johndavid400/Isotope11_traffic_lights/traffic_light.png

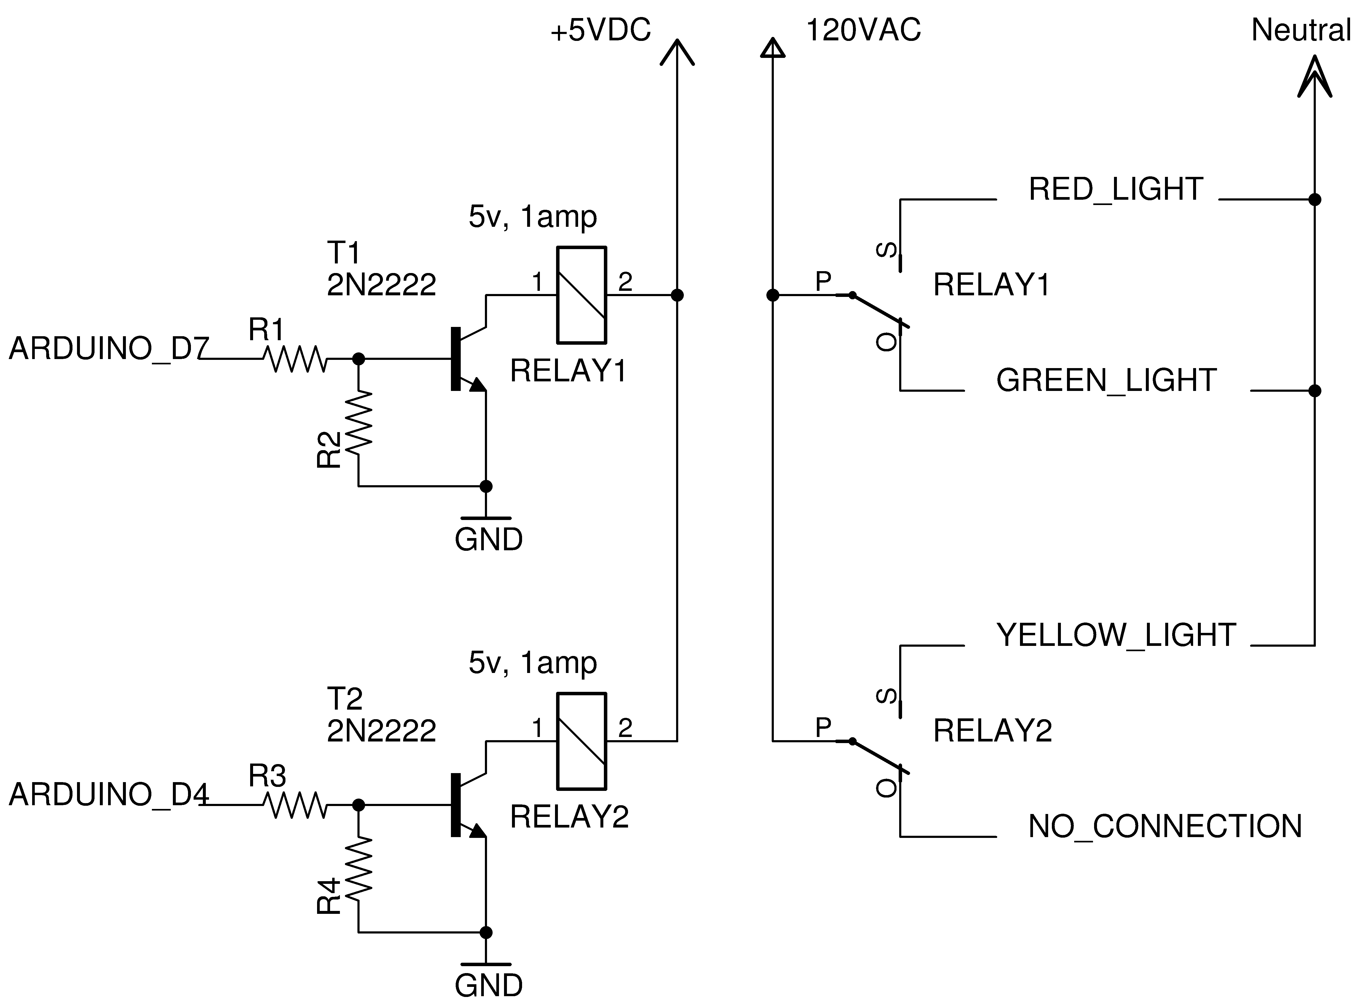
traffic_light.png
