johndavid400/Isotope11_traffic_lights/(commit log)

2012-02-10 added schematic and image
    [traffic_light.sch]
2012-02-10 Add poor man's version, switch to youtube for video.
2012-11-15 fix traffic light for LED's
    [traffic_lights.ino]
